VintherWolf/miotywaffles/doc/Bilag/02 Udvælgelse af Komponenter(SW_og_HW)/01 Info om Valgte Komponenter/S2 - RGB Sensor/S2_Info/S2_Module_Schematic_1334_eng_tds.pdf

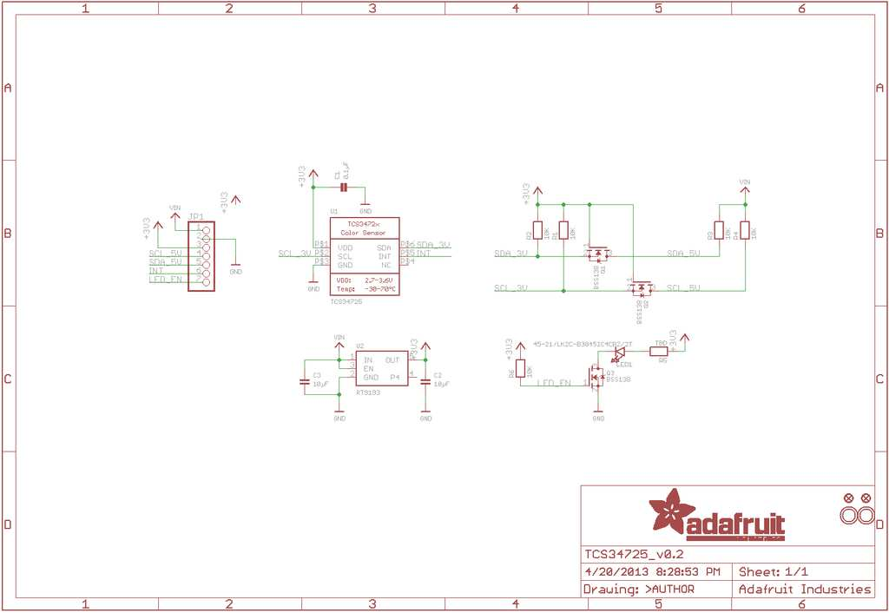
[picture p36: figure]
