VintherWolf/miotywaffles/(list of files, drawings)

Other design files:
doc/Bilag/03_Diagrammer/Hardware - Electrical Schematic/MIOTYWAFFLES.DSN
doc/Bilag/03_Diagrammer/Hardware - Electrical Schematic/miotywaffles.opj
doc/Bilag/03_Diagrammer/Hardware - Electrical Schematic/RGB_SENSOR.OLB
