VintherWolf/miotywaffles/src/Sensors/touchsensor.h

/**
 * @file touchsensor.h
 * @author Daniel K. Vinther Wolf
 * @brief Touch Sensor
 * @version 0.1
 * @date 2020-10-27
 * 
 * 
 */

#include "Particle.h"
#include "../Settings/pinsettings.h"

#ifndef _TOUCHSENSOR_H_
#define _TOUCHSENSOR_H_

/**
 * @brief Initilize GPI for TouchSensor
 * See pinsettings.h
 */
void initTouchSensor();

#endif
