VintherWolf/miotywaffles/(commit log)

2020-09-27 Add Sonos API, process flow and more docs
2020-10-11 Add RGB Color Sensor
2020-10-11 Implement rgb color sensor in miotyWaffles
2020-10-12 Add Electrical Schematic and PASS Testrun with RGB Sensor
    [MIOTYWAFFLES.DSN, RGB_SENSOR.OLB, miotywaffles.opj]
2020-10-20 Add Anglesensor and Electrical Schematic
    [MIOTYWAFFLES.DSN, miotywaffles.opj]
2020-10-20 Update Schematic
    [MIOTYWAFFLES.DSN, miotywaffles.opj]
2020-10-20 Fix color value get methods
    [miotywaffles.cpp]
2020-10-21 Fix namings and restructure setup
    [MIOTYWAFFLES.DSN, miotywaffles.opj]
2020-10-22 Add blue LED as indicator and python weather API
    [MIOTYWAFFLES.DSN, miotywaffles.opj]
2020-10-24 Reorganize files and add image
    [miotywaffles.opj]
2020-10-25 Refine toggle led function
2020-10-25 Add relay functionality
    [MIOTYWAFFLES.DSN, miotywaffles.opj]
2020-10-29 Add buzzer
    [MIOTYWAFFLES.DSN, miotywaffles.opj]
2020-10-29 Update UML sd dia
    [MIOTYWAFFLES.DSN, RGB_SENSOR.OLB, miotywaffles.opj]
2020-10-30 Update electrical diagram with inverter for relay
    [MIOTYWAFFLES.DSN, miotywaffles.opj]
2020-11-03 Add report selection of components and minor upd
    [MIOTYWAFFLES.DSN, miotywaffles.opj]
2020-11-03 Fix too many argument error
    [miotywaffles.cpp]
2020-11-26 Update doc
    [miotywaffles.opj]
